talengu/FloatCup/img/index_stm32_project.png

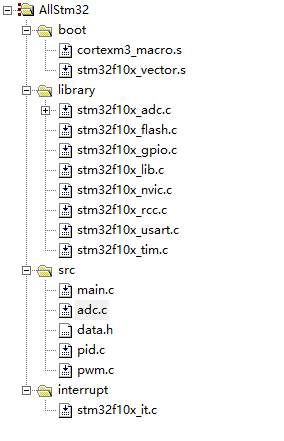
img/index_stm32_project.png
