talengu/FloatCup/project_stm32_final_beta/src/一些未使用文件/多路ADC采样驱动程序.c

 #include "adc.h"
/*----------------------------------------------------------------
 * 文件名称： 多路ADC采样驱动程序  
 * 主控芯片： STM32F103RBT6        
 * 文件说明： PA0对应ADC_IN0，修改引脚的时候需注意 
 *			  1.GPIO初始化的修改	
 *			  2.Get_Adc(ADC_Channel_x)函数中x的修改
 *			  3.ADC模式设置不用修改
 * 			  4.采样时间设置：设置Get_Adc()中的ADC_SampleTime		  		
 * 创建标识：416实验室  曹毅超
 * 创建时间：2013.5.9   
**----------------------------------------------------------------*/	 
		   
//初始化ADC
//这里我们仅以规则通道为例
//我们默认将开启通道0~3																	   
void  Adc_Init(void)
{ 	
	ADC_InitTypeDef ADC_InitStructure; 
	GPIO_InitTypeDef GPIO_InitStructure;
	RCC_APB2PeriphClockCmd(RCC_APB2Periph_GPIOA|RCC_APB2Periph_ADC1	, ENABLE );	  //使能ADC1通道时钟
 						   //RCC_APB2Periph_GPIOx,x=GPIOx
	RCC_ADCCLKConfig(RCC_PCLK2_Div6);   //AD采样时钟72M/6=12M,不能超过14M，否则精度下降
	//PA0--ADC_IN0  PA1--ADC_IN1  PA2--ADC_IN2  PA3--ADC_IN3  PA4--ADC_IN4  PA5--ADC_IN5  PA6--ADC_IN6  PA7--ADC_IN7  
	//PB0--ADC_IN8  PB1--ADC_IN9  PC0--ADC_IN10  PC1--ADC_IN11  PC2--ADC_IN12  PC3--ADC_IN13  PC4--ADC_IN14  PC5--ADC_IN15                   
	//PA0~3  4路作为模拟通道输入引脚                         
    GPIO_InitStructure.GPIO_Pin = GPIO_Pin_0|GPIO_Pin_1|GPIO_Pin_2|GPIO_Pin_3|GPIO_Pin_4|GPIO_Pin_5|GPIO_Pin_6;
	GPIO_InitStructure.GPIO_Mode = GPIO_Mode_AIN;		//配置为模拟输入
	GPIO_Init(GPIOA, &GPIO_InitStructure);			  //x=GPIOx

//------------------------------------ADC设置--------------------------------------------------------

	ADC_DeInit(ADC1);  //将外设 ADC1的全部寄存器重设为缺省值
	ADC_InitStructure.ADC_Mode = ADC_Mode_Independent;	//ADC工作模式:ADC1和ADC2工作在独立模式
	ADC_InitStructure.ADC_ScanConvMode = DISABLE;	//模数转换工作在单通道模式
	ADC_InitStructure.ADC_ContinuousConvMode = DISABLE;	//模数转换工作在单次转换模式
	ADC_InitStructure.ADC_ExternalTrigConv = ADC_ExternalTrigConv_None;	//转换由软件而不是外部触发启动
	ADC_InitStructure.ADC_DataAlign = ADC_DataAlign_Right;	//ADC数据右对齐
	ADC_InitStructure.ADC_NbrOfChannel = 1;	//顺序进行规则转换的ADC通道的数目，此处为1个通道
	ADC_Init(ADC1, &ADC_InitStructure);	//根据ADC_InitStruct中指定的参数初始化外设ADCx的寄存器   

	ADC_Cmd(ADC1, ENABLE);	//使能指定的ADC1
	ADC_ResetCalibration(ADC1);	//重置指定的ADC1的校准寄存器
	while(ADC_GetResetCalibrationStatus(ADC1));	//获取ADC1重置校准寄存器的状态,直到校准寄存器设置完成
	ADC_StartCalibration(ADC1);		//开始指定ADC1的校准状态
	while(ADC_GetCalibrationStatus(ADC1));		//获取指定ADC1的校准程序,直到校准完成
	ADC_SoftwareStartConvCmd(ADC1, ENABLE);		//使能指定的ADC1的软件转换启动功能

}				  
//获得ADC值
//ch:通道值 0~3
u16 Get_Adc(u8 ch)   
{	unsigned int result=0;
	unsigned char i;

  	//设置指定ADC的规则组通道，设置它们的转化顺序和采样时间
	ADC_RegularChannelConfig(ADC1, ch, 1, ADC_SampleTime_239Cycles5 );	//ADC1,ADC通道ch,规则采样顺序值序列为1,采样时间为239.5周期	  			    
  	for(i=0;i<8;i++)
	{
		ADC_SoftwareStartConvCmd(ADC1, ENABLE);		//使能指定的ADC1的软件转换启动功能	 
		while(!ADC_GetFlagStatus(ADC1, ADC_FLAG_EOC ));//等待转换结束
		result+=ADC_GetConversionValue(ADC1);
	}
	result=result/8;	 //取8次采样的平均值
	return result;	//返回平均值
}
