talengu/FloatCup/(commit log)

2017-01-04 磁悬浮项目稳定代码与设计报告
    还没有达到控制要求里的全部内容
2017-01-04 修改readme，并调整目录结构
2017-01-22 修复一下下载链接
2017-03-13 更新readme
2017-03-19 添加题目要求与原理图
2017-03-19 图片不对
